FatemaJanahi/Sun-Shooter/README.md

# Sun-Shooter
Bow and Arrow style game for the Boston Children's Museum's Cornerstone Exhibition.
